melixxa07/Color-Detector-With-Arduino/README.md

[Trash Sorter by Color Video](https://youtu.be/BW1Dfk8DBD8?si=3t45LqhjrShm5cNO)
