melixxa07/Color-Detector-With-Arduino/Color_Detector_Arduino_Code/Color_Detector.ino

int RED = 2;
int GREEN = 3;
int BLUE = 4;
int option;

void setup() {
  // put your setup code here, to run once:
  Serial.begin(9600);
  pinMode(RED, OUTPUT);
  pinMode(GREEN, OUTPUT);
  pinMode(BLUE, OUTPUT);
  option='D';
}

void loop() {
  // put your main code here, to run repeatedly:
  if (Serial.available() > 0){
    option = Serial.read();
    Serial.println(option);
    if (option == 'R'){
      digitalWrite(RED, HIGH);
      digitalWrite(GREEN, LOW);
      digitalWrite(BLUE, LOW);
    }

    if (option == 'G'){
      digitalWrite(RED, LOW);
      digitalWrite(GREEN, HIGH);
      digitalWrite(BLUE, LOW);
    }

    if (option == 'B'){
      digitalWrite(RED, LOW);
      digitalWrite(GREEN, LOW);
      digitalWrite(BLUE, HIGH);
    }

    if (option == 'D'){
      digitalWrite(RED, LOW);
      digitalWrite(GREEN, LOW);
      digitalWrite(BLUE, LOW);
    }

  }

}
